Junior-Kabulo/GPS-Tracker-automobile/images/3D_BOTTOM_PCB.png

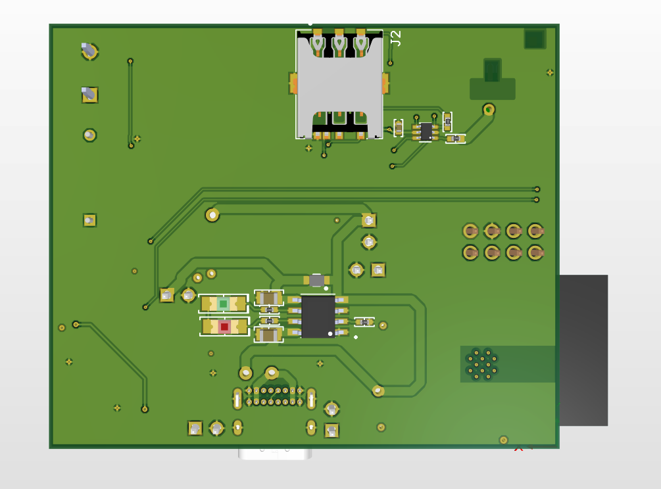
images/3D_BOTTOM_PCB.png
