Junior-Kabulo/GPS-Tracker-automobile/images/3D_PCB_ISOMETRIC.png

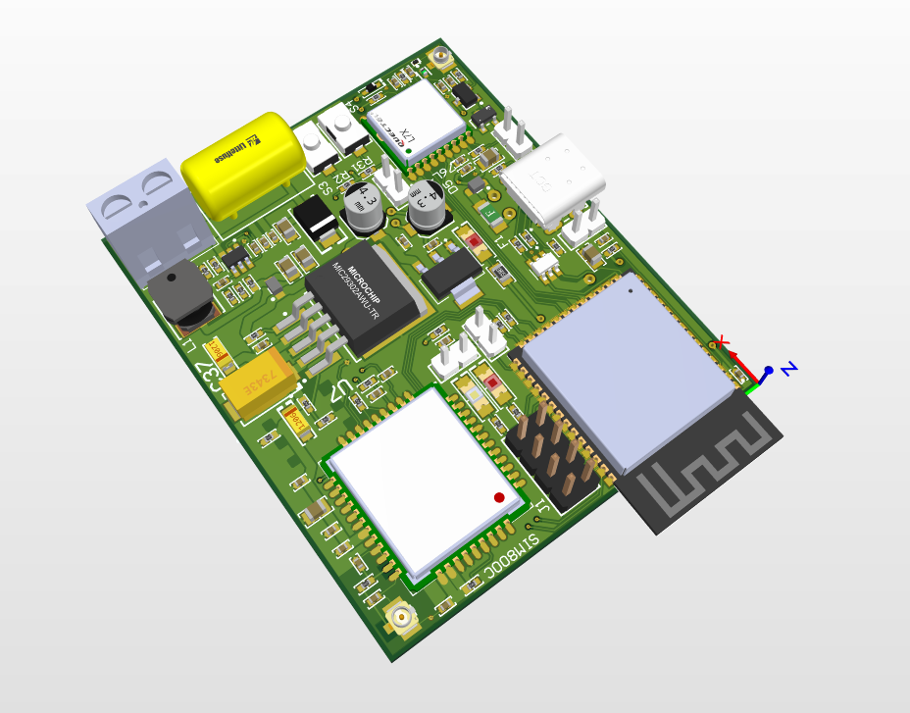
images/3D_PCB_ISOMETRIC.png
