Junior-Kabulo/GPS-Tracker-automobile/images/2Layer_FOR_GND.png

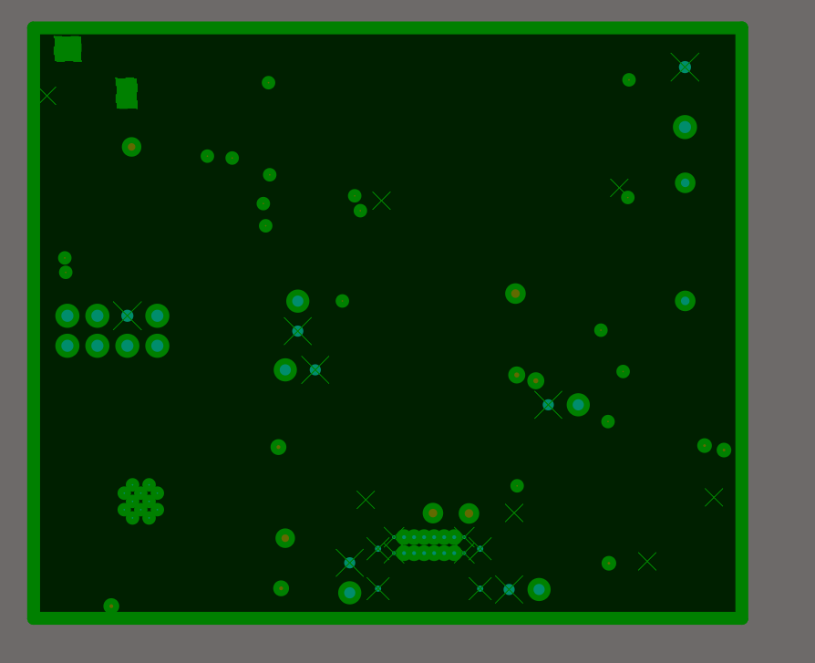
images/2Layer_FOR_GND.png
