Junior-Kabulo/GPS-Tracker-automobile/images/3D_TOP_PCB.png

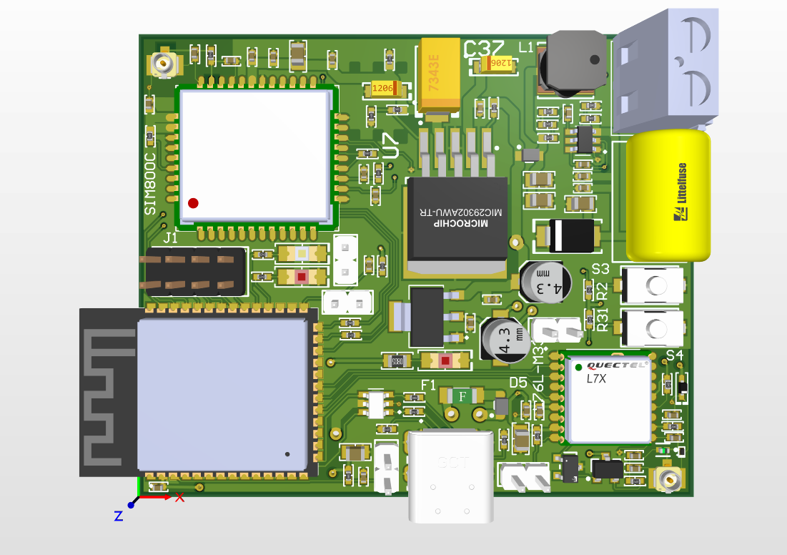
images/3D_TOP_PCB.png
