Junior-Kabulo/GPS-Tracker-automobile/images/3Layer_FOR_3V3.png

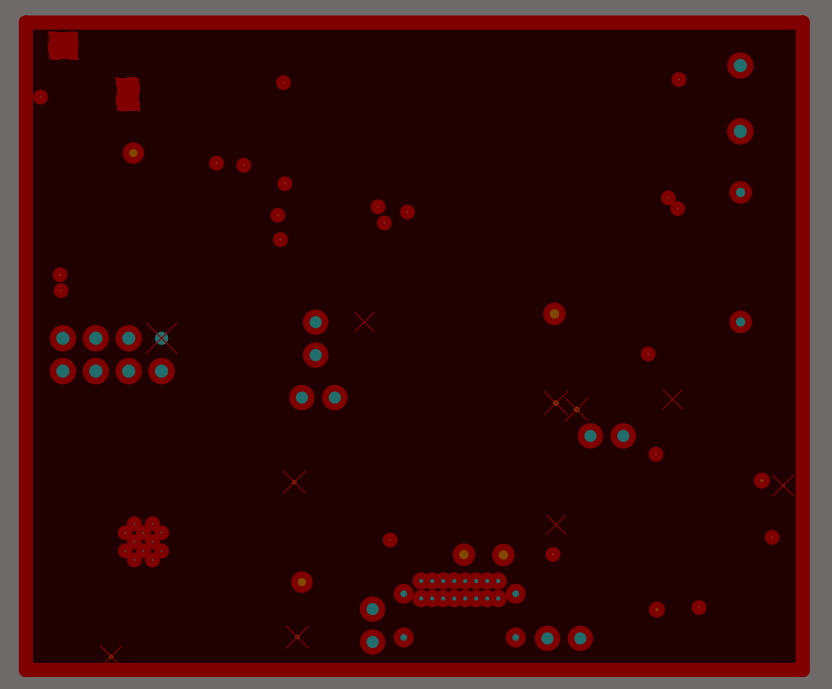
images/3Layer_FOR_3V3.png
