Junior-Kabulo/GPS-Tracker-automobile/images/BOTTOM_LAYER.png

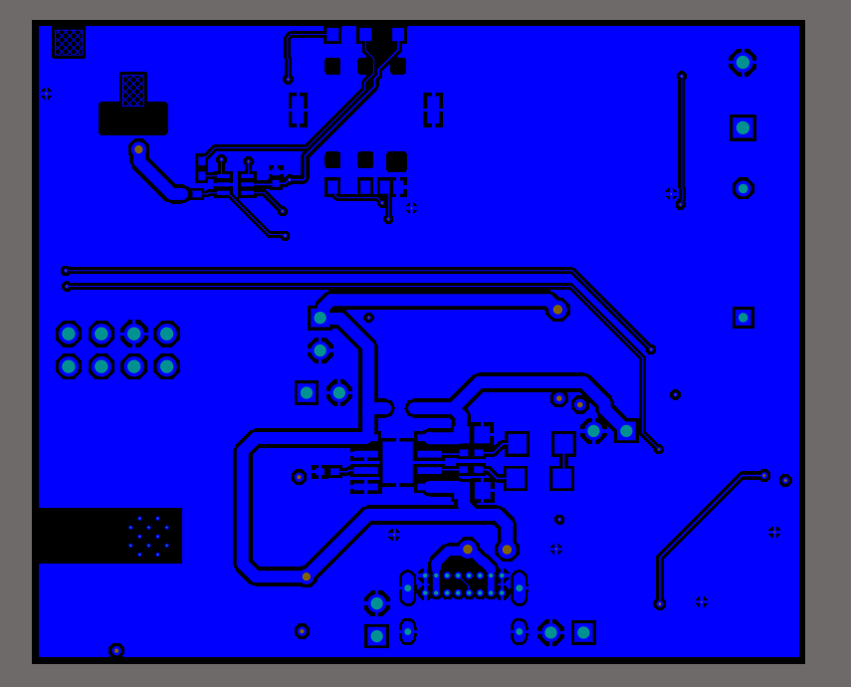
images/BOTTOM_LAYER.png
