Junior-Kabulo/GPS-Tracker-automobile/images/TOP_LAYER.png

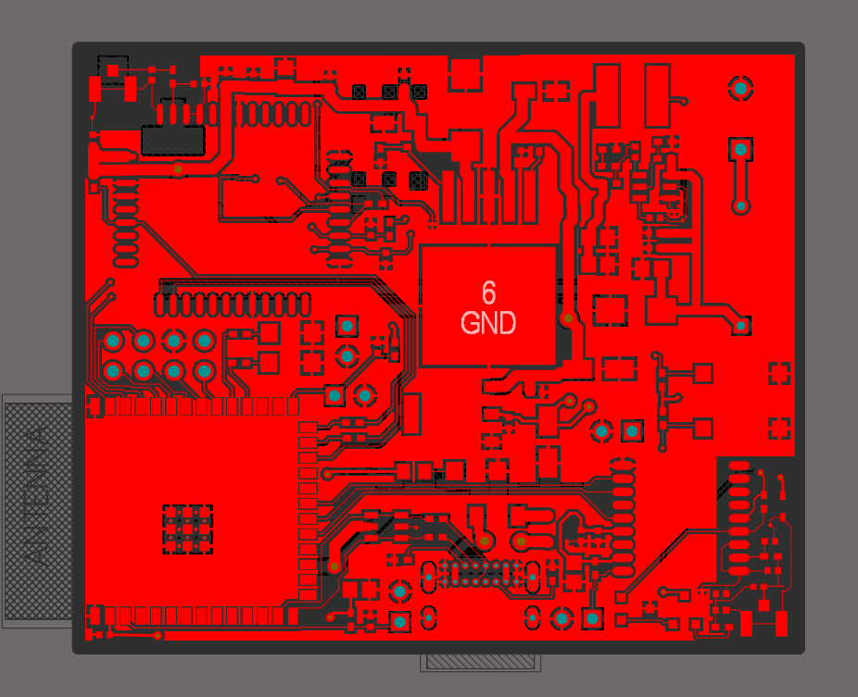
images/TOP_LAYER.png
