Junior-Kabulo/GPS-Tracker-automobile/GPS_Tracker_V1.pdf

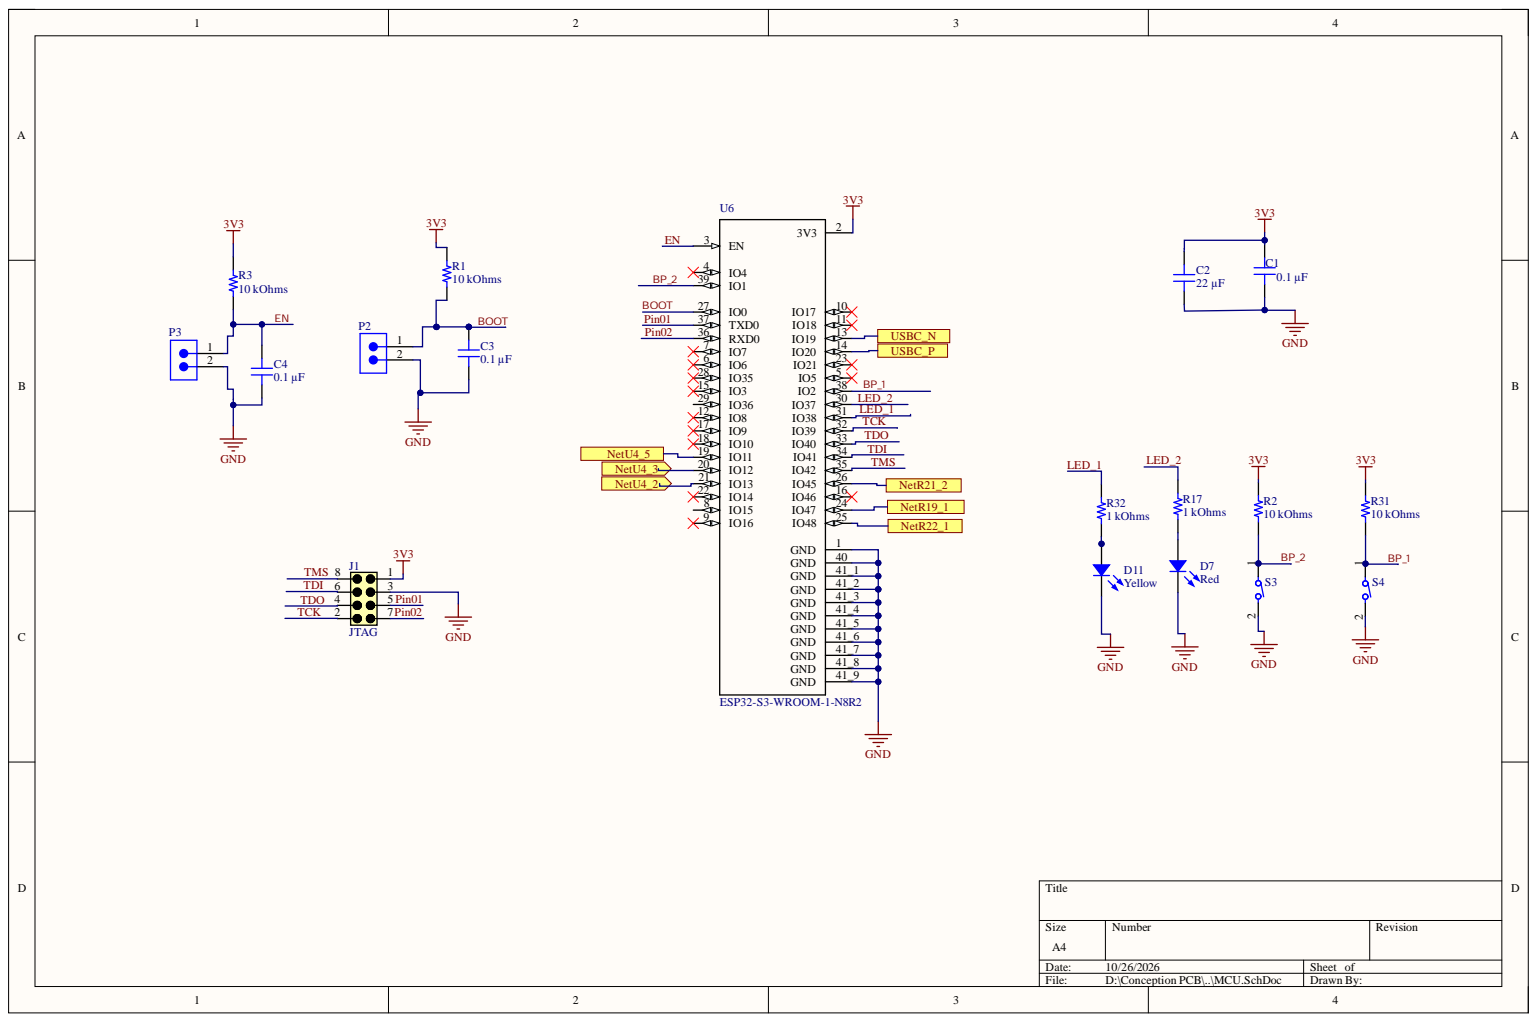
[picture p8: page 1]

4 0
4 1 _ | 1

TMS TDI TDO TCK

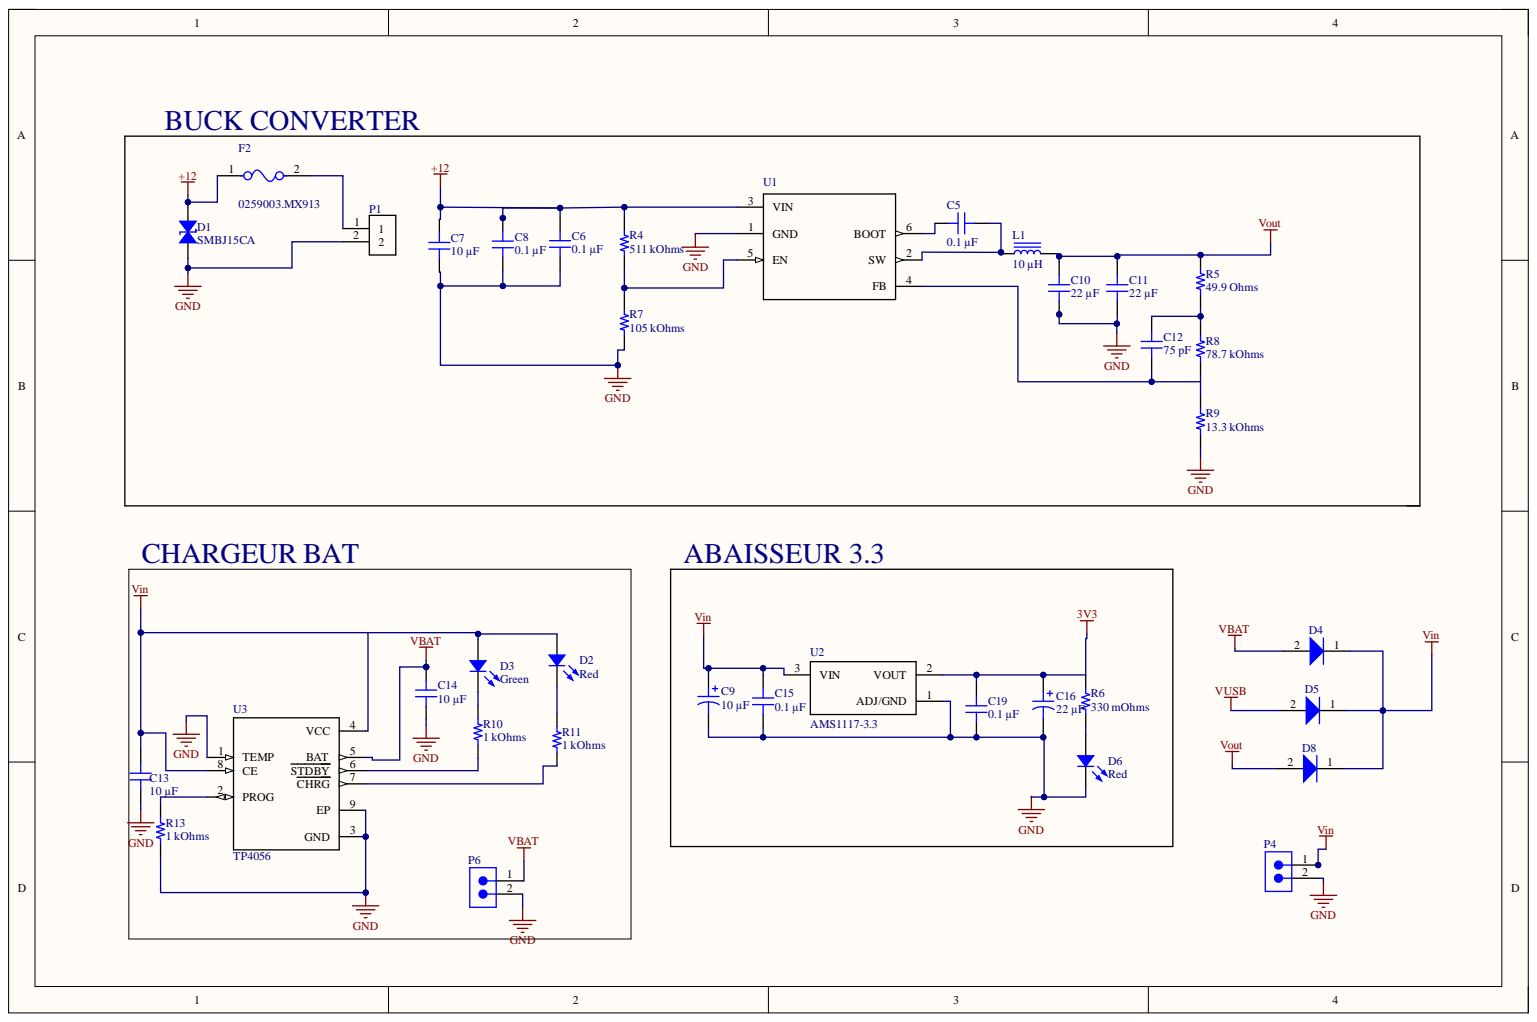
[picture p9: page 2]

GND 1

GND | | | C10 | C11 R9 13.3 kOhms

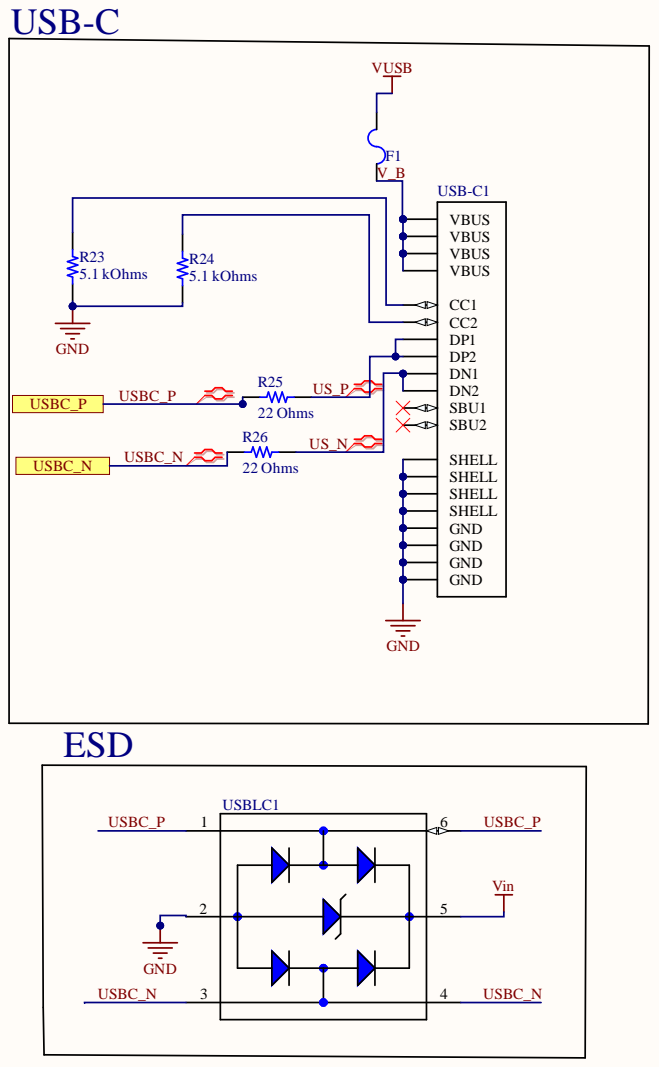
[picture p10: page 3]

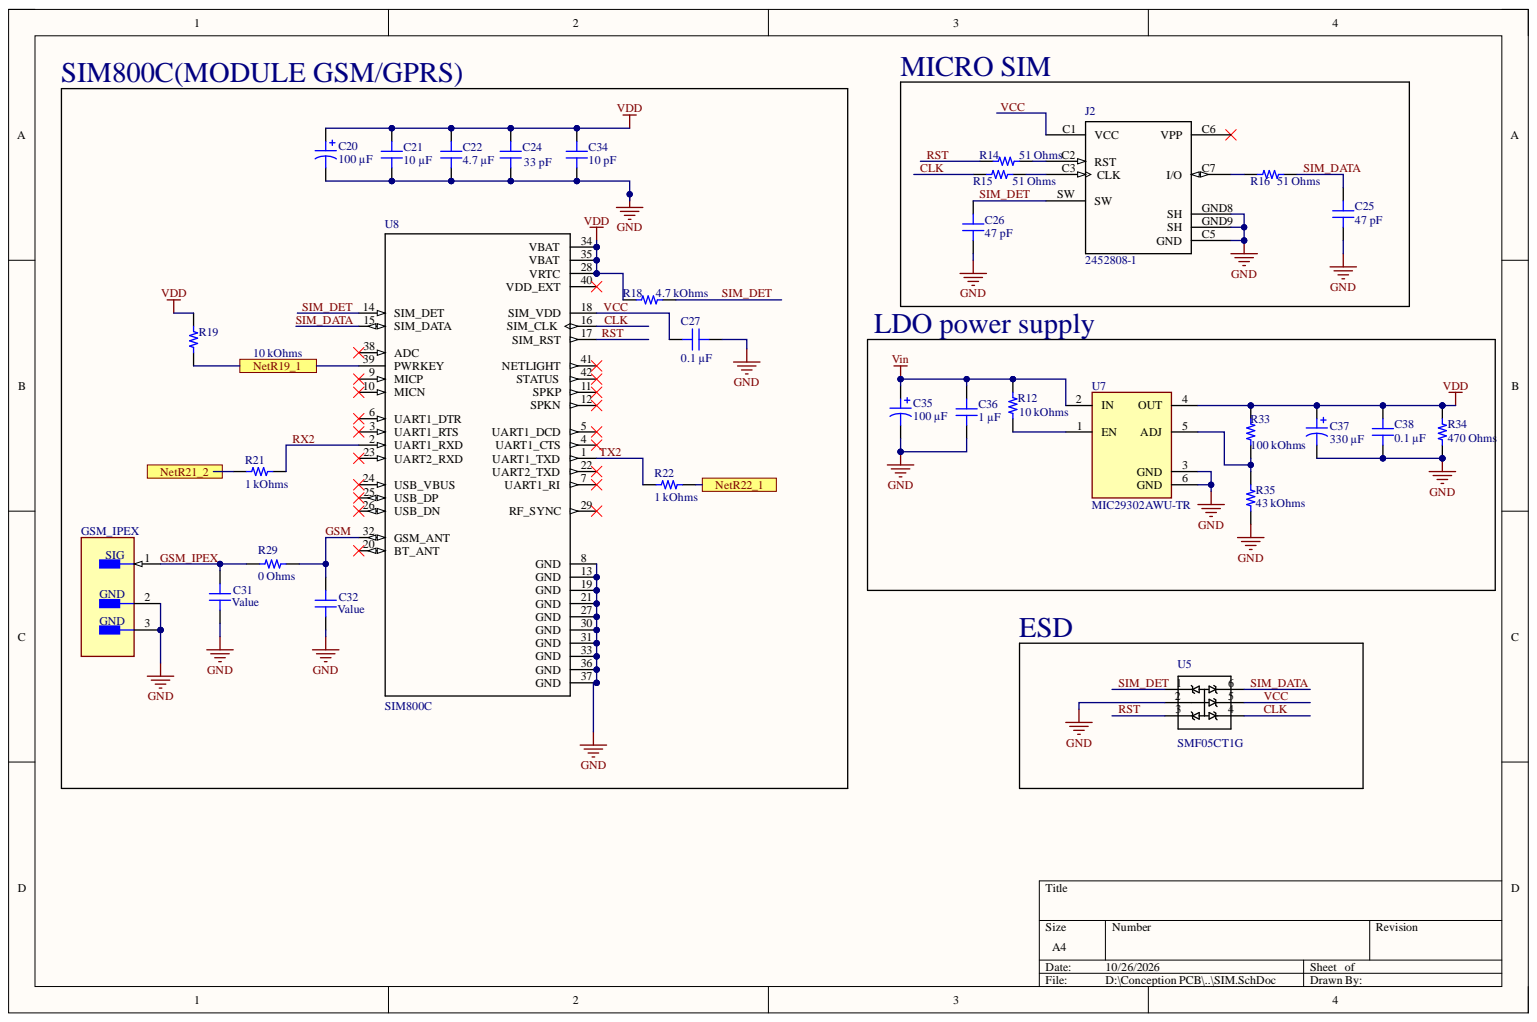
[picture p11: page 4]

GSM | 2 3 | 1

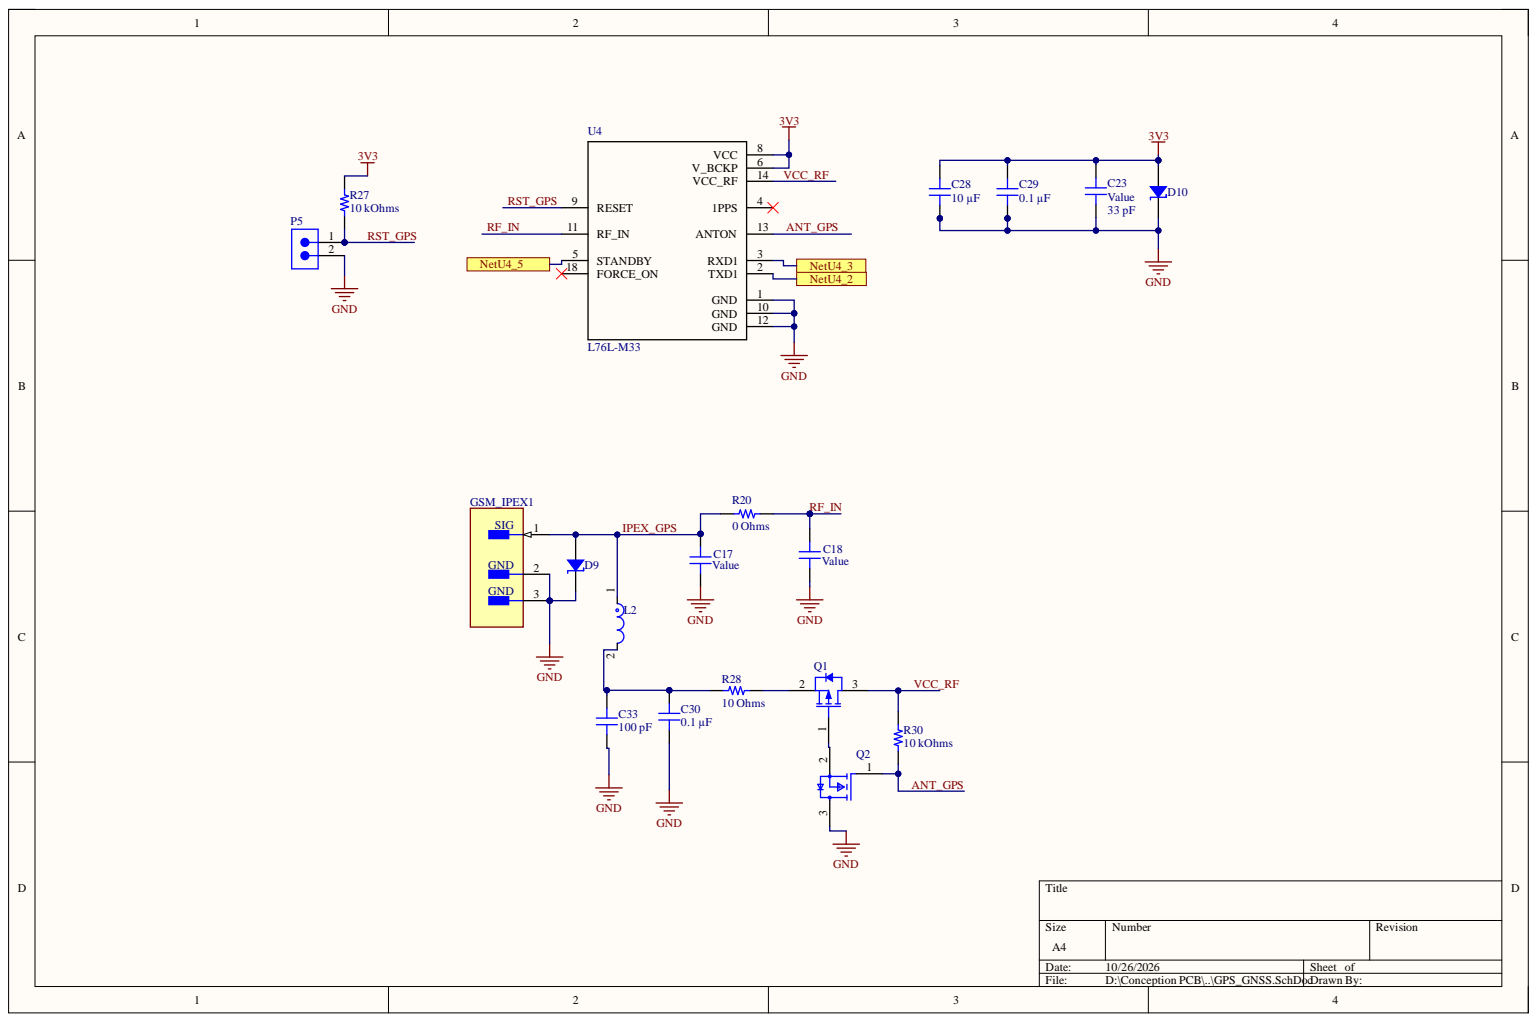
[picture p12: page 5]

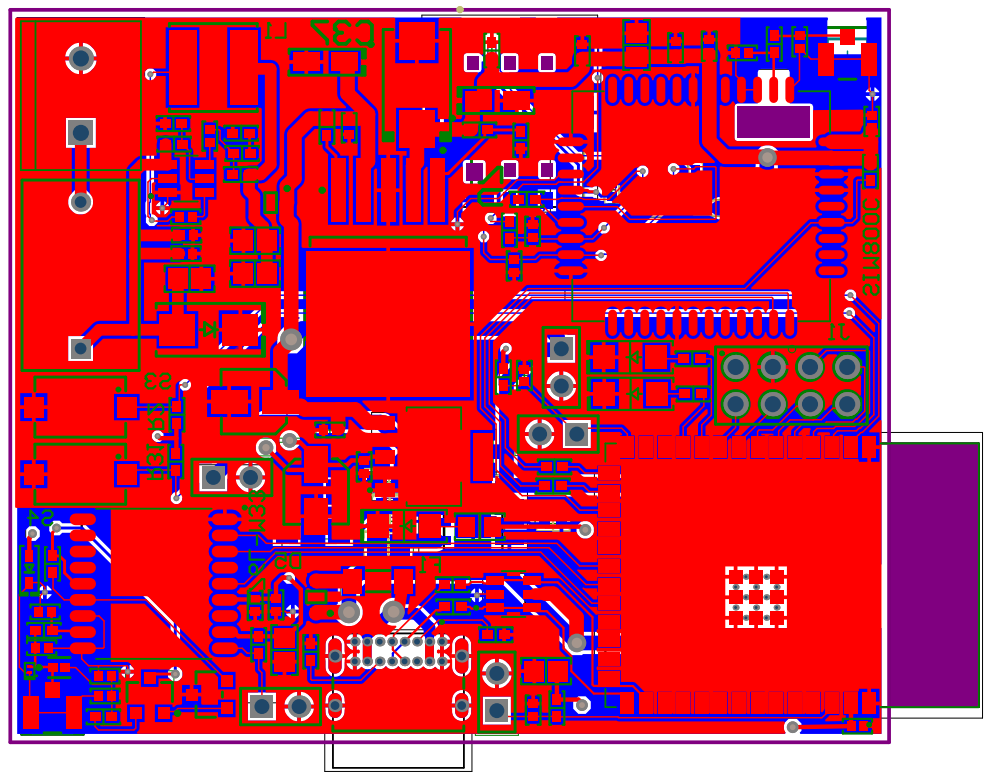
[picture p13: page 6]

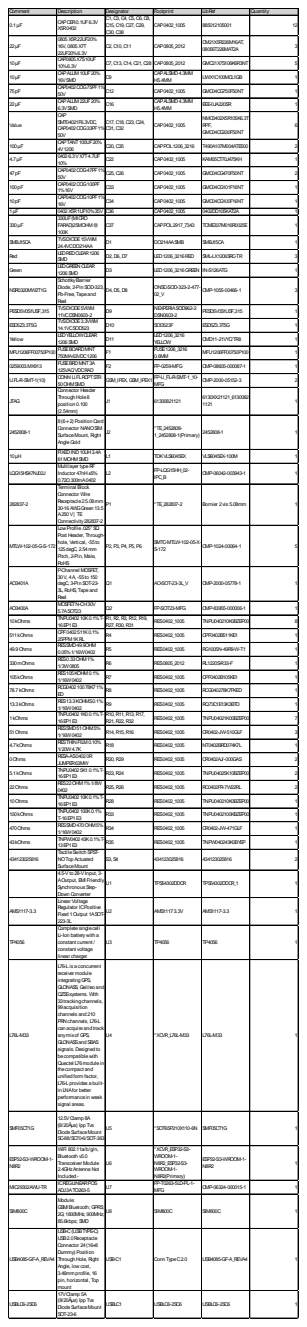
[picture p14: page 7]

0.1µF | CAPCER0.1UF6.3V X5R0402 | C1, C3, C4, C5, C6, C8, C15, C19, C27, C29, C30, C38 | CAP0402_1005 | 885012105001 | 12

22µF | 0805X5R22UF20% 16V, 0805X7T 22UF20%6.3V | C2, C10, C11 | CAP0805_2012 | CM21X5R226M16AT, 08056T226MAT2A | | 3

10µF | CAP0805X7S10UF 10%6.3V | C7, C13, C14, C21, C28 | CAP0805_2012 | GMC21X7S106K6R3NT | | 5

10µF | CAPALUM10UF20% 16VSMD | C9 | CAPALSMD4.3MM H5.4MM | UWX1C100MCL1GB | | 1

75pF | CAP0402COG75PF1% 50V | C12 | CAP0402_1005 | GMC04CG750F50NT | | 1

22µF | CAPALUM22UF20% 6.3VSMD | C16 | CAPALSMD4.3MM H5.4MM | EEE-0JA220SR | | 1

Value | CAP SMT04021F6.3VDC, CAP0402COG33PF1% 50V | C17, C18, C23, C24, C31, C32 | CAP0402_1005 | NMC0402X5R105K6.3T RPF, GMC04CG330F50NT | | 6

100µF | CAPTANT100UF20% 4V1206 | C20, C35 | CAPPOL1206_3216 | T490A107M004ATE500 | | 2

4.7µF | 04026.3VX7T4.7UF 10% | C22 | CAP0402_1005 | KAM05CT70J475KH | | 1

47pF | CAP0402COG47PF1% 50V | C25, C26 | CAP0402_1005 | GMC04CG470F50NT | | 2

100pF | CAP0402COG100PF 1%16V | C33 | CAP0402_1005 | GMC04CG101F16NT | | 1

10pF | CAP0402COG10PF1% 16V | C34 | CAP0402_1005 | GMC04CG100F16NT | | 1

1µF | 0402X5R1UF10%35V | C36 | CAP0402_1005 | 0402DD105KAT2A | | 1
330µF | 330UF(MICRO FARAD)25MOHM@ 100K | C37 | CAPPOL2917_7343 | TCME337M016R0025E | | 1

SMBJ15CA | TVSDIODE15VWM 24.4VCDO214AA | D1 | DO214AASMB | SMBJ15CA | | 1

Red | LEDREDCLEAR1206 SMD | D2, D6, D7 | LED1206_3216RED | SML-LX1206SRC-TR | | 3

Green | LEDGREEN CLEAR 1206SMD | D3 | LED1206_3216GREEN | IN-S126ATG | | 1

NSR0320MW2T1G | SchottkyBarrier Diode, 2-Pin SOD-323, Pb-Free, Tapeand Reel | D4, D5, D8 | ONSC-SOD-323-2-477-02_V | CMP-1055-00466-1 | | 3

PESD5V0S1USF,315 | TVSDIODE5VWM 11VCDSN0603-2 | D9 | NEXPERIASOD962-2 DSN0603-2 | PESD5V0S1USF,315 | | 1

ESD5Z3.3T5G | TVSDIODE3.3VWM 14.1VCSOD523 | D10 | SOD523F | ESD5Z3.3T5G | | 1

Yellow | LEDYELLOWCLEAR 1206SMD | D11 | LED1206_3216 YELLOW | CMD11-21VYC/TR8 | | 1

MFU1206FF00750P100 | FUSEBOARDMNT 750MA63VDC1206 | F1 | FUSE1206_3216 0.6MM | MFU1206FF00750P100 | | 1

0259003.MX913 | FUSEBRDMNT3A 125VAC/VDCRAD | F2 | FP-0259-MFG | CMP-08605-000087-1 | | 1

U.FL-R-SMT-1(10) | CONN U.FLRCPTSTR 50OHMSMD | GSM_IPEX, GSM_IPEX1 | FP-U_FL-R-SMT-1_10-MFG | CMP-2000-05152-3 | | 2

JTAG | Connector Header Through Hole8 position 0.100 (2.54mm) | J1 | 61300821121 | 6130XX21121_6130082 1121 | | 1

2452808-1 | 8(6+2) Position Card Connector NANOSIM SurfaceMount, Right AngleGold | J2 | *TE_2452808-1_2452808-1(Primary) | 2452808-1 | | 1

10µH | FIXEDIND10UH3.4A 61MOHMSMD | L1 | TDKVLS6045EX | VLS6045EX-100M | | 1

LQG15HS47NJ02J | Multilayer typeRF Inductor 47nH±5% 0.72Ω300mA0402 | L2 | FP-LQG15HH_02-IPC_B | CMP-06042-003943-1 | | 1

282837-2 | Terminal Block Connector Wire Receptacle25.08mm 30-16AWGGreen 13.5 A250V| TE Connectivity282837-2 | P1 | *TE_282837-2 | Bornier 2vis 5.08mm | | 1

MTLW-102-05-G-S-172 | Low Profile.025" SQ Post Header, Through-hole, Vertical, -55to 125degC, 2.54mm Pitch, 2-Pin, Male, RoHS | P2, P3, P4, P5, P6 | SMTC-MTLW-102-05-X-S-172 | CMP-1024-00064-1 | | 5

AO3401A | P-Channel MOSFET, 30V, 4A, -55to 150 degC, 3-Pin SOT-23-3L, RoHS, Tapeand Reel | Q1 | AO-SOT-23-3L_V | CMP-2000-05778-1 | | 1

AO3400A | MOSFETN-CH30V 5.7ASOT23 | Q2 | FP-SOT23-MFG | CMP-83955-000006-1 | | 1

10kOhms | TNPU040210K0.1%T-16EP1E3 | R1, R2, R3, R12, R19, R27, R30, R31 | RES0402_1005 | TNPU040210K0BZEP00 | | 8

511kOhms | CPF0402511K0.1% 25PPM1KRL | R4 | RES0402_1005 | CPF0402B511KE1 | | 1

49.9Ohms | RESSMD49.9OHM 0.05%1/16W0402 | R5 | RES0402_1005 | RG1005N-49R9-W-T1 | | 1

330mOhms | RES0.33OHM1% 1/3W0805 | R6 | RES0805_2012 | RL1220S-R33-F | | 1

105kOhms | RES105KOHM0.1% 1/16W0402 | R7 | RES0402_1005 | CPF0402B105KE1 | | 1

78.7kOhms | RCG040210078K71% ED | R8 | RES0402_1005 | RCG040278K7FKED | | 1

13.3kOhms | RES13.3KOHMS0.1% 1/16W0402 | R9 | RES0402_1005 | RQ73C1E13K3BTD | | 1

1kOhms | TNPU04021K00.1%T-16EP1E3 | R10, R11, R13, R17, R21, R22, R32 | RES0402_1005 | TNPU04021K00BZEP00 | | 7

51Ohms | RESSMD51OHM5% 1/16W0402 | R14, R15, R16 | RES0402_1005 | CR0402-JW-510GLF | | 3

4.7kOhms | RESTHIN FILM0.10% 1/20W4.7K | R18 | RES0402_1005 | NT0402BRD074K7L | | 1

0Ohms | RESA-AS04020R JUMPER63MW | R20, R29 | RES0402_1005 | CR0402AJ/-000GAS | | 2

5.1kOhms | TNPU04025K10.1%T-16EP1E3 | R23, R24 | RES0402_1005 | TNPU04025K10BZEP00 | | 2

22Ohms | RES22OHM1%1/8W 0402 | R25, R26 | RES0402_1005 | RC0402FR-7W22RL | | 2

10Ohms | TNPU040210K0.1%T-16EP1E3 | R28 | RES0402_1005 | TNPU040210K0BZEP00 | | 1

100kOhms | TNPU0402100K0.1% T-16EP1E3 | R33 | RES0402_1005 | TNPU0402100KBZEP00 | | 1

470Ohms | RESSMD470OHM5% 1/16W0402 | R34 | RES0402_1005 | CR0402-JW-471GLF | | 1

43kOhms | TNPW040243K0.1%T-13EP1E3 | R35 | RES0402_1005 | TNPW040243K0BYEP | | 1

434123025816 | TactileSwitch SPST-NOTop Actuated SurfaceMount | S3, S4 | 434123025816 | 434123025816 | | 2

4.5-Vto 28-VInput, 3-AOutput, EMI Friendly SynchronousStep-Down Converter | U1 | TPS54302DDCR | TPS54302DDCR_1 | | 1

AMS1117-3.3 | Linear Voltage Regulator ICPositive Fixed 1Output 1ASOT-223-3L | U2 | AMS11173.3V | AMS1117-3.3 | | 1

TP4056 | Completesinglecell Li-Ion battery with a constant current / constant voltage linear charger | U3 | TP4056 | TP4056 | | 1

L76L-M33 | L76-Lis a concurrent receiver module integratingGPS, GLONASS, Galileo and QZSSsystems. With 33trackingchannels, 99acquisition channels and 210 PRN channels, L76-L can acquire and track anymixof GPS, GLONASSand SBAS signals. Designed to becompatiblewith Quectel L76modulein thecompact and unified form factor, L76-Lprovides a built-in LNAfor better performancein weak signal areas. | U4 | *XCVR_L76L-M33 | L76L-M33 | | 1

SMF05CT1G | 12.5VClamp 8A (8/20Âµs) Ipp Tvs DiodeSurfaceMount SC-88/SC70-6/SOT-363 | U5 | *SOT65P210X110-6N | SMF05CT1G | | 1

ESP32-S3-WROOM-1-N8R2 | WiFi 802.11a/b/g/n, Bluetooth v5.0 Transceiver Module 2.4GHzAntenna Not Included - | U6 | *XCVR_ESP32-S3-WROOM-1-N8R2_ESP32-S3-WROOM-1-N8R2(Primary) | ESP32-S3-WROOM-1-N8R2 | | 1

MIC29302AWU-TR | ICREGLINEARPOS ADJ3ATO263-5 | U7 | FP-T0263-5LD-PL-1-MFG | CMP-06324-000015-1 | | 1

SIM800C | Module: GSM/Bluetooth; GPRS; 2G; 1800MHz, 900MHz; 85.6kbps; SMD | U8 | SIM800C | SIM800C | | 1

USB4085-GF-A_REVA4 | USB-C(USBTYPE-C) USB2.0Receptacle Connector 24(16+8 Dummy) Position Through Hole, Right Angle, low cost, 3.46mm profile, 16 pin, horizontal, Top mount | USB-C1 | Conn TypeC2.0 | USB4085-GF-A_REVA4 | | 1

USBLC6-2SC6 | 17VClamp 5A (8/20Âµs) Ipp Tvs DiodeSurfaceMount SOT-23-6 | USBLC1 | USBLC6-2SC6 | USBLC6-2SC6 | | 1
