Junior-Kabulo/GPS-Tracker-automobile/(list of files, drawings)

Other design files:
hardware/PCB/GPS_Tracker_V1.PrjPcb
hardware/PCB/PCB.PcbDoc
hardware/PCB/PcbLib1.PcbLib
hardware/PCB/Schlib1.SchLib
hardware/Shematic/Alimentation.SchDoc
hardware/Shematic/GPS_GNSS.SchDoc
hardware/Shematic/MCU.SchDoc
hardware/Shematic/SIM.SchDoc
hardware/Shematic/USB-C.SchDoc
