Junior-Kabulo/GPS-Tracker-automobile/(commit log)

2026-10-25 Les fichiers sources modifiables d'Altium Designer
    [Alimentation.SchDoc, GPS_GNSS.SchDoc, GPS_Tracker_V1.PrjPcb, MCU.SchDoc, PCB.PcbDoc, PcbLib1.PcbLib, SIM.SchDoc, Schlib1.SchLib]
2026-10-25 Ajout de image
2026-10-25 Add GPS Tracker PCB project files
    [Alimentation.SchDoc, GPS_GNSS.SchDoc, GPS_Tracker_V1.PrjPcb, GPS_Tracker_V1.xlsx, MCU.SchDoc, PCB.PcbDoc, PcbLib1.PcbLib, SIM.SchDoc]
2026-10-25 Move PCB, BOM and schematic files into hardware
    [Alimentation.SchDoc, GPS_GNSS.SchDoc, GPS_Tracker_V1.PrjPcb, GPS_Tracker_V1.xlsx, MCU.SchDoc, PCB.PcbDoc, PcbLib1.PcbLib, SIM.SchDoc]
2026-10-26 Add hardware design files
    [Alimentation.SchDoc, GPS_GNSS.SchDoc, GPS_Tracker_V1.PrjPcb, GPS_Tracker_V1.xlsx, MCU.SchDoc, PCB.PcbDoc, PcbLib1.PcbLib, SIM.SchDoc]
2026-10-26 Revise README for GPS Tracker Automobile project
    Updated project details, objectives, and structure for the GPS Tracker Automobile PCB design.
